F-Sakashita/Micromouse/3DCAD/mount_silk.dxf

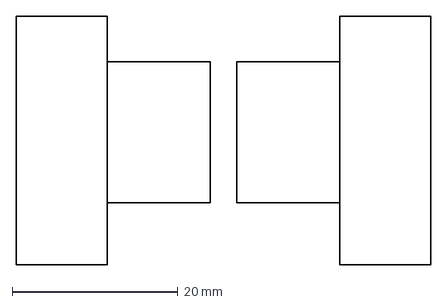
[picture p1: CAD file, 2020-11-21]
3DCAD/mount_silk.dxf
50.0 x 30.0 mm
