F-Sakashita/Micromouse/3DCAD/Chassis_and_Mount.dxf

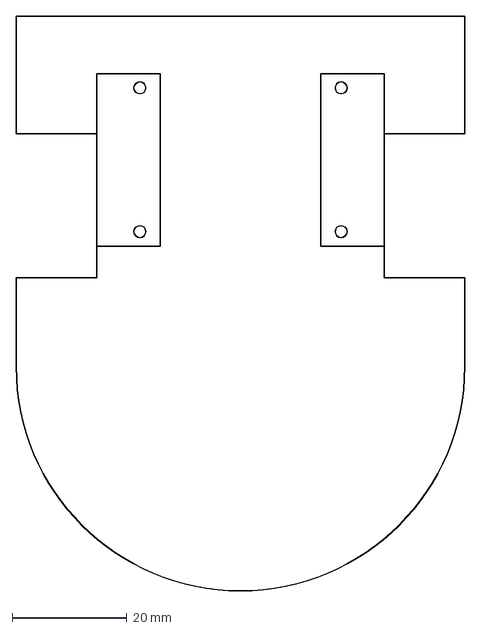
[picture p2: CAD file, 2020-11-15]
3DCAD/Chassis_and_Mount.dxf
78.0 x 100.0 mm
