F-Sakashita/Micromouse/3DCAD/Chassis.dxf

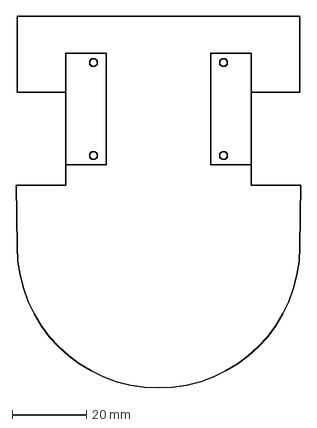
[picture p3: CAD file, 2020-11-14]
3DCAD/Chassis.dxf
76.5 x 100.0 mm
