F-Sakashita/Micromouse/3DCAD/シャーシ.stl

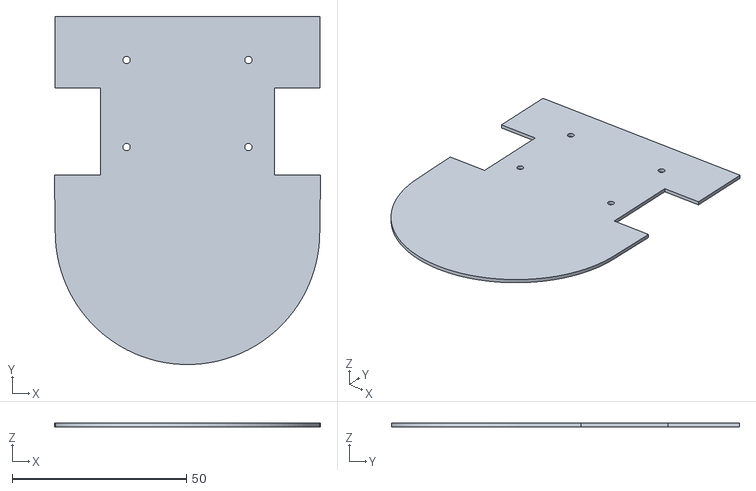
[picture p4: CAD file, 2020-11-14]
3DCAD/シャーシ.stl
76.5 x 100.0 x 1.10
