F-Sakashita/Micromouse/(list of files, cad)

Other CAD files:
3DCAD/シャーシ v1.dxf
