F-Sakashita/Micromouse/circuit/Micromouse.kicad_pcb

## KiCad design circuit/Micromouse.kicad_pcb (2021-02-14)

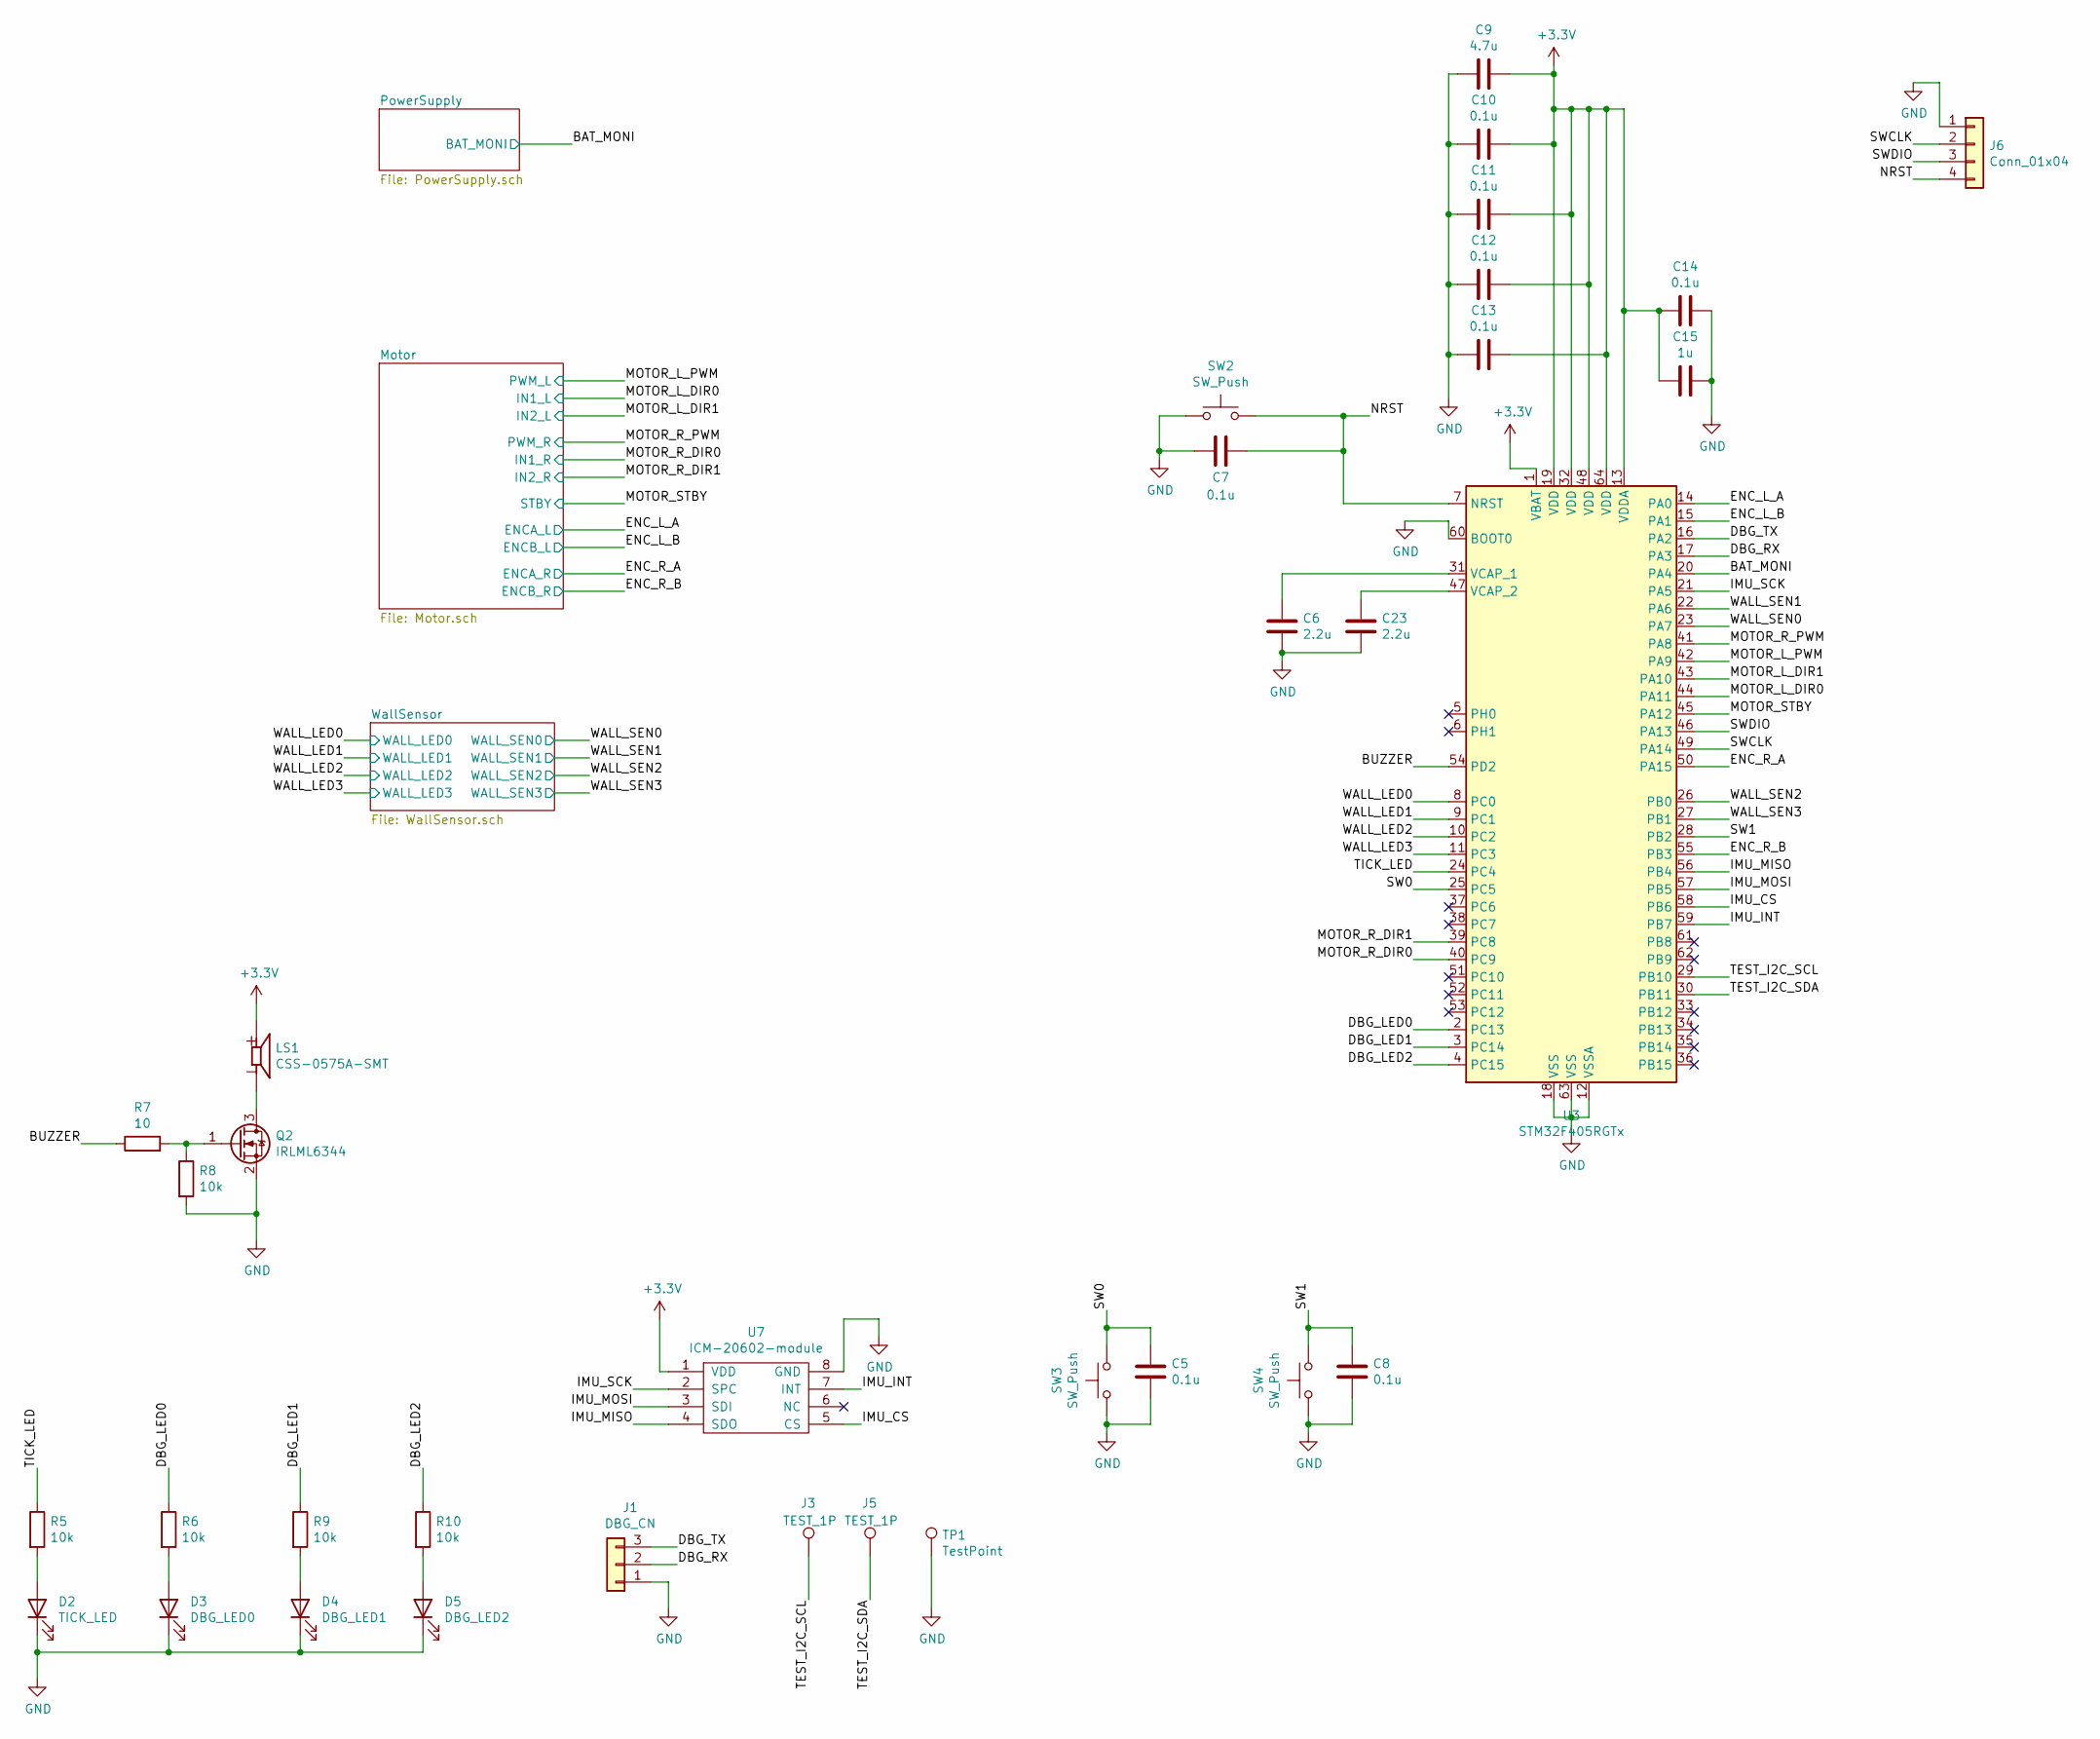
[picture p5: schematic Micromouse.sch]

Parts:
C5, C7, C8, C10, C11, C12, C13, C14: 0.1u; C_0603_1608Metric
C6, C23: 2.2u; C_0603_1608Metric
C9: 4.7u; C_0603_1608Metric
C15: 1u; C_0603_1608Metric
D2: TICK_LED; LED_0603_1608Metric
D3: DBG_LED0; LED_0603_1608Metric
D4: DBG_LED1; LED_0603_1608Metric
D5: DBG_LED2; LED_0603_1608Metric
J1: DBG_CN; PinSocket_1x03_P2.54mm_Vertical
J3, J5: TEST_1P; TestPoint_Pad_D1.0mm
J6: Conn_01x04; PinSocket_1x04_P2.54mm_Vertical
LS1: CSS-0575A-SMT; CUI_CSS-0575A-SMT
Q2: IRLML6344; SOT-23
R5, R6, R8, R9, R10: 10k; R_0603_1608Metric
R7: 10; R_0603_1608Metric
SW2, SW3, SW4: SW_Push; SW_TACT_ALPS_SKRPABE010
TP1: TestPoint; TestPoint_Pad_D1.0mm
U3: STM32F405RGTx; LQFP-64_10x10mm_P0.5mm
U7: ICM-20602-module; ICM-20602

Connections:
+3V3: C9.1, C10.1, C11.1, C12.1, C13.1, C14.2, C15.2, LS1.1, U3.1 (VBAT), U3.13 (VDDA), U3.19 (VDD), U3.32 (VDD), U3.48 (VDD), U3.64 (VDD), U7.1 (VDD); also elsewhere on the board
/BAT_MONI: U3.20 (PA4); also elsewhere on the board
/BUZZER: R7.1, U3.54 (PD2)
/DBG_LED0: R6.1, U3.2 (PC13)
/DBG_LED1: R9.1, U3.3 (PC14)
/DBG_LED2: R10.1, U3.4 (PC15)
/DBG_RX: J1.2, U3.17 (PA3)
/DBG_TX: J1.3, U3.16 (PA2)
/ENC_L_A: U3.14 (PA0); also elsewhere on the board
/ENC_L_B: U3.15 (PA1); also elsewhere on the board
/ENC_R_A: U3.50 (PA15); also elsewhere on the board
/ENC_R_B: U3.55 (PB3); also elsewhere on the board
/IMU_CS: U3.58 (PB6), U7.5 (CS)
/IMU_INT: U3.59 (PB7), U7.7 (INT)
/IMU_MISO: U3.56 (PB4), U7.4 (SDO)
/IMU_MOSI: U3.57 (PB5), U7.3 (SDI)
/IMU_SCK: U3.21 (PA5), U7.2 (SPC)
/MOTOR_L_DIR0: U3.44 (PA11); also elsewhere on the board
/MOTOR_L_DIR1: U3.43 (PA10); also elsewhere on the board
/MOTOR_L_PWM: U3.42 (PA9); also elsewhere on the board
/MOTOR_R_DIR0: U3.40 (PC9); also elsewhere on the board
/MOTOR_R_DIR1: U3.39 (PC8); also elsewhere on the board
/MOTOR_R_PWM: U3.41 (PA8); also elsewhere on the board
/MOTOR_STBY: U3.45 (PA12); also elsewhere on the board
/NRST: C7.1, J6.4, SW2.2, U3.7 (NRST)
/SW0: C5.1, SW3.2, U3.25 (PC5)
/SW1: C8.1, SW4.2, U3.28 (PB2)
/SWCLK: J6.2, U3.49 (PA14)
/SWDIO: J6.3, U3.46 (PA13)
/TEST_I2C_SCL: J3.1, U3.29 (PB10)
/TEST_I2C_SDA: J5.1, U3.30 (PB11)
/TICK_LED: R5.1, U3.24 (PC4)
/WALL_LED0: U3.8 (PC0); also elsewhere on the board
/WALL_LED1: U3.9 (PC1); also elsewhere on the board
/WALL_LED2: U3.10 (PC2); also elsewhere on the board
/WALL_LED3: U3.11 (PC3); also elsewhere on the board
/WALL_SEN0: U3.23 (PA7); also elsewhere on the board
/WALL_SEN1: U3.22 (PA6); also elsewhere on the board
/WALL_SEN2: U3.26 (PB0); also elsewhere on the board
/WALL_SEN3: U3.27 (PB1); also elsewhere on the board
GND: C5.2, C6.2, C7.2, C8.2, C9.2, C10.2, C11.2, C12.2, C13.2, C14.1, C15.1, C23.2, D2.1 (K), D3.1 (K), D4.1 (K), D5.1 (K), J1.1, J6.1, Q2.2 (S), R8.2, SW2.1, SW3.1, SW4.1, TP1.1, U3.12 (VSSA), U3.18 (VSS), U3.60 (BOOT0), U3.63 (VSS), U7.8 (GND); also elsewhere on the board
unnamed: C6.1, U3.31 (VCAP_1)
unnamed: C23.1, U3.47 (VCAP_2)
unnamed: D2.2 (A), R5.2
unnamed: D3.2 (A), R6.2
unnamed: D4.2 (A), R9.2
unnamed: D5.2 (A), R10.2
unnamed: LS1.2, Q2.3 (D)
unnamed: Q2.1 (G), R7.2, R8.1

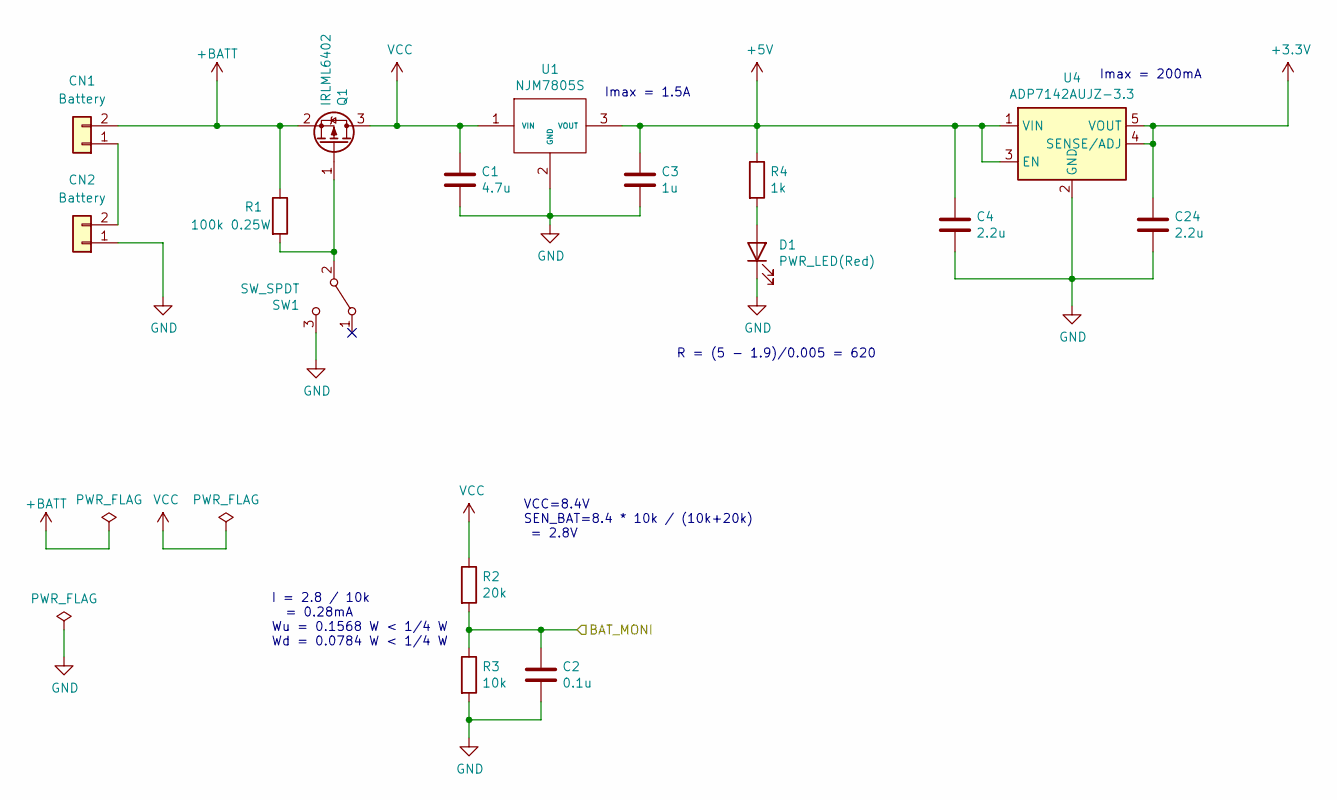
[picture p6: schematic PowerSupply.sch]

Parts:
C1: 4.7u; C_0805_2012Metric
C2: 0.1u; C_0603_1608Metric
C3: 1u; C_0603_1608Metric
C4, C24: 2.2u; C_0603_1608Metric
CN1, CN2: Battery; JST_PH_B2B-PH-K_1x02_P2.00mm_Vertical
D1: PWR_LED(Red); LED_0603_1608Metric
Q1: IRLML6402; SOT-23
R1: 100k 0.25W; R_0603_1608Metric
R2: 20k; R_0805_2012Metric
R3: 10k; R_0805_2012Metric
R4: 1k; R_0603_1608Metric
SW1: SW_SPDT; SW_CuK_JS202011CQN_DPDT_Straight
U1: NJM7805S; TO-252-2
U4: ADP7142AUJZ-3.3; TSOT-23-5

Connections:
+3V3: C24.1, U4.4 (SENSE/ADJ), U4.5 (VOUT); also elsewhere on the board
+5V: C3.1, C4.1, R4.1, U1.3 (VOUT), U4.1 (VIN), U4.3 (EN); also elsewhere on the board
+BATT: CN1.2, Q1.2 (S), R1.1
/BAT_MONI: C2.1, R2.2, R3.1; also elsewhere on the board
GND: C1.2, C2.2, C3.2, C4.2, C24.2, CN2.1, D1.1 (K), R3.2, SW1.3 (C), U1.2 (GND), U4.2 (GND); also elsewhere on the board
unnamed: CN1.1, CN2.2
unnamed: D1.2 (A), R4.2
unnamed 64: Q1.1 (G), R1.2, SW1.2 (B); also elsewhere on the board
VCC: C1.1, Q1.3 (D), R2.1, U1.1 (VIN); also elsewhere on the board

Notes on the sheet:
VCC=8.4V SEN_BAT=8.4 * 10k / (10k+20k) = 2.8V
Imax = 1.5A
Imax = 200mA
R = (5 - 1.9)/0.005 = 620
I = 2.8 / 10k = 0.28mA Wu = 0.1568 W < 1/4 W Wd = 0.0784 W < 1/4 W

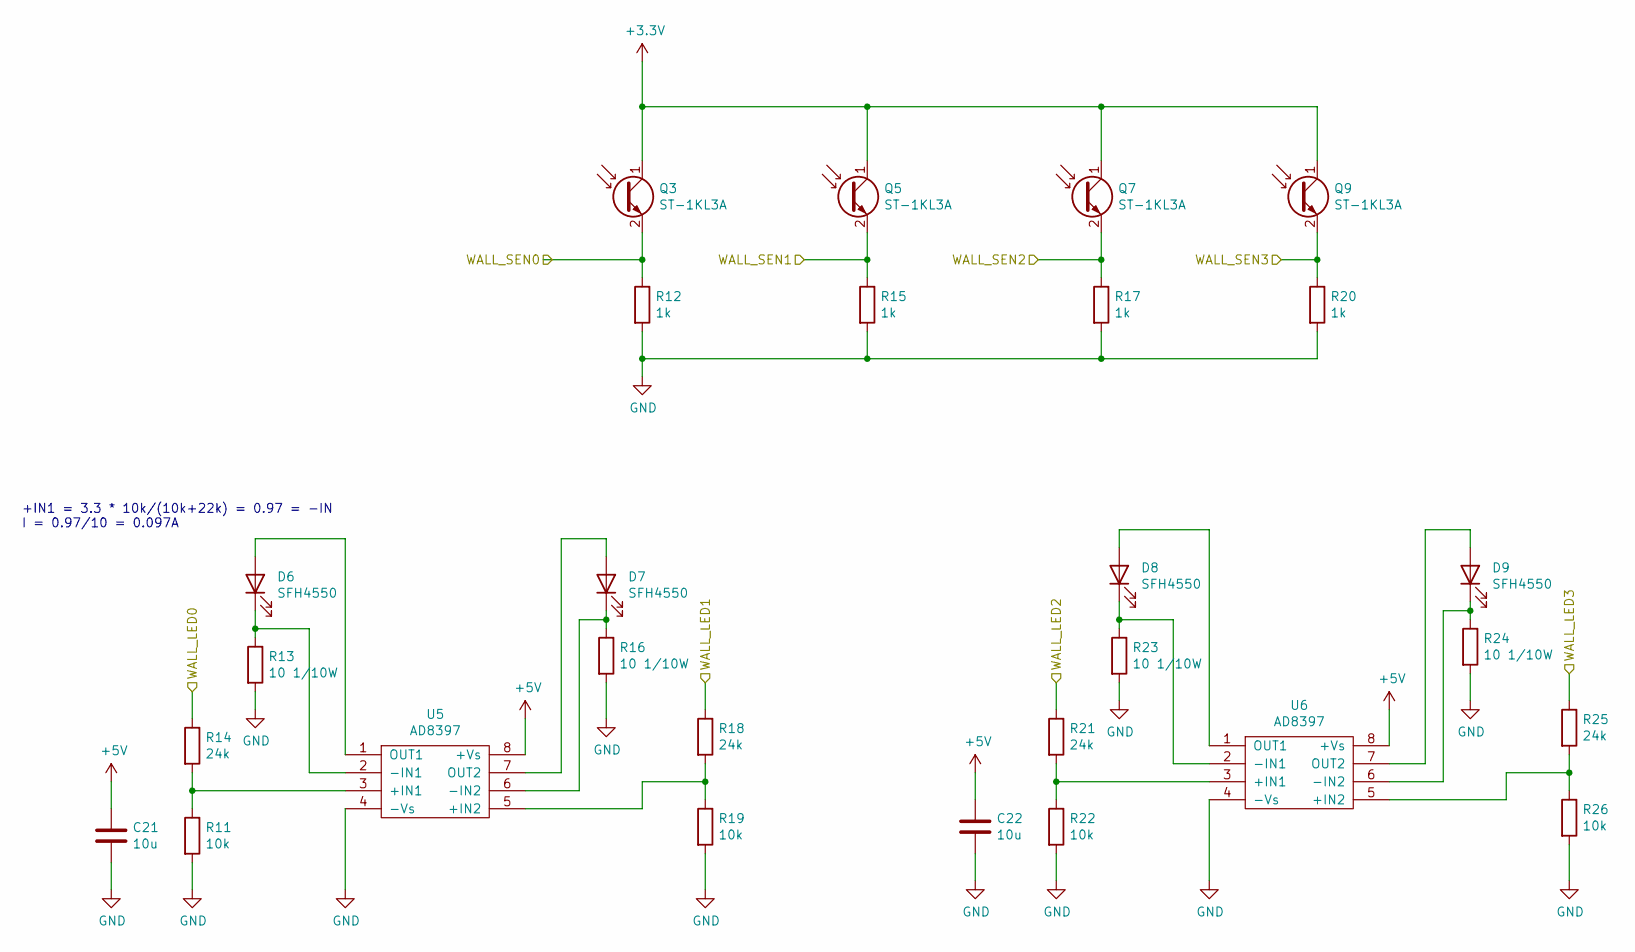
[picture p7: schematic WallSensor.sch]

Parts:
C21, C22: 10u; C_0603_1608Metric
D6, D7: SFH4550; LED_D5.0mm_Horizontal_O3.81mm_Z9.0mm
D8, D9: SFH4550; LED_D5.0mm_Horizontal_O3.81mm_Z9.0mm_reverse
Q3, Q5, Q7, Q9: ST-1KL3A; ST-1KL3A_ForWall
R11, R19, R22, R26: 10k; R_0603_1608Metric
R12, R15, R17, R20: 1k; R_0603_1608Metric
R13, R16, R23, R24: 10 1/10W; R_0603_1608Metric
R14, R18, R21, R25: 24k; R_0603_1608Metric
U5, U6: AD8397; SOIC-8_3.9x4.9mm_P1.27mm

Connections:
+3V3: Q3.1 (C), Q5.1 (C), Q7.1 (C), Q9.1 (C); also elsewhere on the board
+5V: C21.1, C22.1, U5.8 (+Vs), U6.8 (+Vs); also elsewhere on the board
/WALL_LED0: R14.1; also elsewhere on the board
/WALL_LED1: R18.1; also elsewhere on the board
/WALL_LED2: R21.1; also elsewhere on the board
/WALL_LED3: R25.1; also elsewhere on the board
/WALL_SEN0: Q3.2 (E), R12.1; also elsewhere on the board
/WALL_SEN1: Q5.2 (E), R15.1; also elsewhere on the board
/WALL_SEN2: Q7.2 (E), R17.1; also elsewhere on the board
/WALL_SEN3: Q9.2 (E), R20.1; also elsewhere on the board
GND: C21.2, C22.2, R11.2, R12.2, R13.2, R15.2, R16.2, R17.2, R19.2, R20.2, R22.2, R23.2, R24.2, R26.2, U5.4 (-Vs), U6.4 (-Vs); also elsewhere on the board
unnamed: D6.1 (K), R13.1, U5.2 (-IN1)
unnamed: D6.2 (A), U5.1 (OUT1)
unnamed: D7.1 (K), R16.1, U5.6 (-IN2)
unnamed: D7.2 (A), U5.7 (OUT2)
unnamed: D8.1 (K), R23.1, U6.2 (-IN1)
unnamed: D8.2 (A), U6.1 (OUT1)
unnamed: D9.1 (K), R24.1, U6.6 (-IN2)
unnamed: D9.2 (A), U6.7 (OUT2)
unnamed: R11.1, R14.2, U5.3 (+IN1)
unnamed: R18.2, R19.1, U5.5 (+IN2)
unnamed: R21.2, R22.1, U6.3 (+IN1)
unnamed: R25.2, R26.1, U6.5 (+IN2)

Notes on the sheet:
+IN1 = 3.3 * 10k/(10k+22k) = 0.97 = -IN I = 0.97/10 = 0.097A

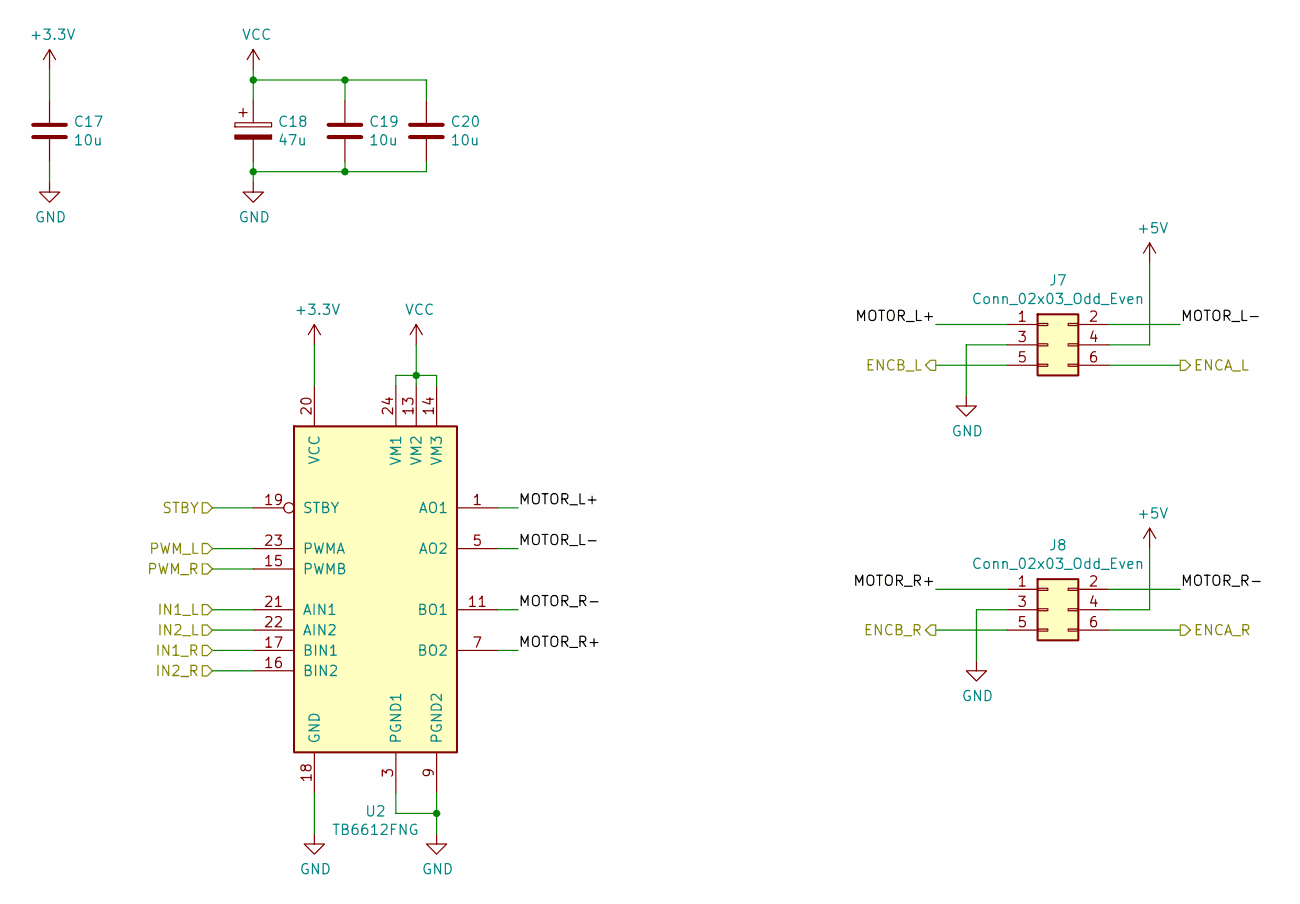
[picture p8: schematic Motor.sch]

Parts:
C17, C19, C20: 10u; C_0805_2012Metric
C18: 47u; CP_Elec_6.3x7.7
J7, J8: Conn_02x03_Odd_Even; IDC-Header_2x03_P2.54mm_Vertical
U2: TB6612FNG; SSOP-24_5.3x8.2mm_P0.65mm

Connections:
+3V3: C17.1, U2.20 (VCC); also elsewhere on the board
+5V: J7.4, J8.4; also elsewhere on the board
/ENC_L_A: J7.6; also elsewhere on the board
/ENC_L_B: J7.5; also elsewhere on the board
/ENC_R_A: J8.6; also elsewhere on the board
/ENC_R_B: J8.5; also elsewhere on the board
/MOTOR_L_DIR0: U2.21 (AIN1); also elsewhere on the board
/MOTOR_L_DIR1: U2.22 (AIN2); also elsewhere on the board
/MOTOR_L_PWM: U2.23 (PWMA); also elsewhere on the board
/MOTOR_R_DIR0: U2.17 (BIN1); also elsewhere on the board
/MOTOR_R_DIR1: U2.16 (BIN2); also elsewhere on the board
/MOTOR_R_PWM: U2.15 (PWMB); also elsewhere on the board
/MOTOR_STBY: U2.19 (STBY); also elsewhere on the board
/Motor/MOTOR_L+: J7.1, U2.1 (AO1), U2.2 (AO1)
/Motor/MOTOR_L-: J7.2, U2.5 (AO2), U2.6 (AO2)
/Motor/MOTOR_R+: J8.1, U2.7 (BO2), U2.8 (BO2)
/Motor/MOTOR_R-: J8.2, U2.11 (BO1), U2.12 (BO1)
GND: C17.2, C18.2, C19.2, C20.2, J7.3, J8.3, U2.3 (PGND1), U2.4 (PGND1), U2.9 (PGND2), U2.10 (PGND2), U2.18 (GND); also elsewhere on the board
VCC: C18.1, C19.1, C20.1, U2.13 (VM2), U2.14 (VM3), U2.24 (VM1); also elsewhere on the board

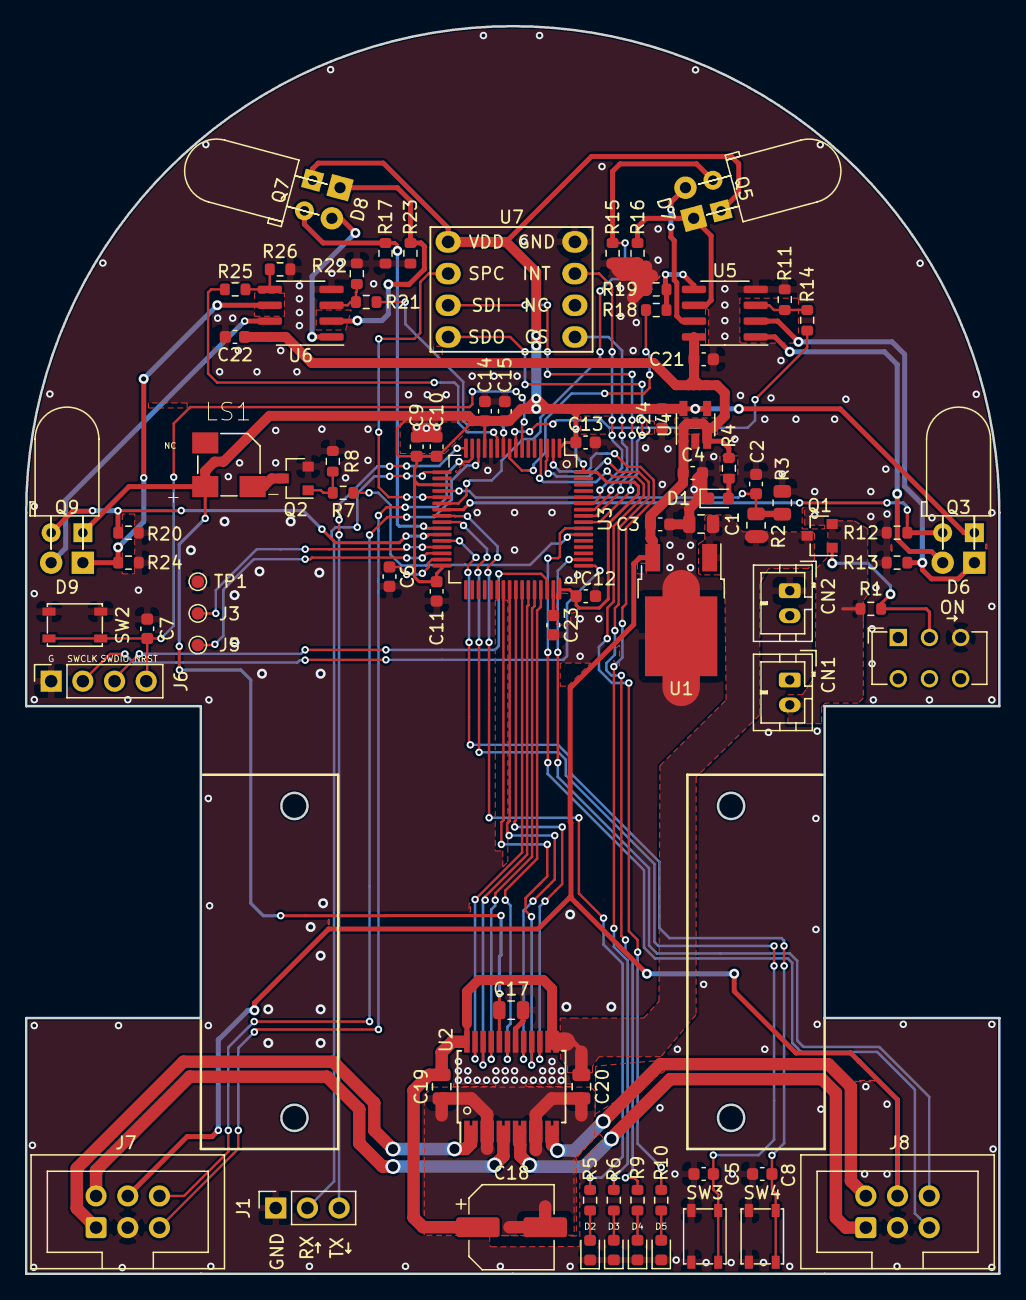
[picture p9: board Micromouse.kicad_pcb from above]

Board: 2 copper layers, 78.0 x 100.0 mm, 85 parts (0 on the bottom side), 71 nets.

Other parts of the board:
ON: SW_SPDT; SW_CuK_JS202011CQN_DPDT_Straight

Their connections:
GND: ON.3; also elsewhere on the board
unnamed 64: ON.2; also elsewhere on the board
