F-Sakashita/Micromouse/firmware/Prototype/Prototype.ioc

PB6.GPIO_Label=IMU_CS
PA6.GPIO_Label=WALL_SEN1
PC15-OSC32_OUT.GPIO_Label=DBG_LED2
PB6.Signal=GPIO_Output
PC3.Signal=GPIO_Output
PB2.Signal=GPIO_Input
PC13-ANTI_TAMP.Signal=GPIO_Output
PC4.GPIO_Label=TICK_LED
PB1.GPIO_Label=WALL_SEN3
PA8.Signal=S_TIM1_CH1
PB1.Signal=ADCx_IN9
PA10.Signal=GPIO_Output
PA4.GPIO_Label=BAT_MONI
PC13-ANTI_TAMP.GPIO_Label=DBG_LED0
PA9.GPIO_Label=MOTOR_L_PWM
PC2.Signal=GPIO_Output
PA11.GPIO_Label=MOTOR_L_DIR0
PC0.Signal=GPIO_Output
PC14-OSC32_IN.Signal=GPIO_Output
PA0-WKUP.GPIO_Label=ENC_R_A
PA0-WKUP.Signal=S_TIM5_CH1
PA8.GPIO_Label=MOTOR_R_PWM
PA9.Signal=S_TIM1_CH2
PB10.Signal=I2C2_SCL
PA5.Signal=SPI1_SCK
PB4.GPIO_Label=IMU_MISO
PA1.GPIO_Label=ENC_R_B
PA4.Signal=ADCx_IN4
PB5.Signal=SPI1_MOSI
PA5.GPIO_Label=IMU_SCK
PA11.Signal=GPIO_Output
PC3.GPIO_Label=WALL_LED3
PD2.Signal=GPIO_Output
PB0.Signal=ADCx_IN8
PC1.Signal=GPIO_Output
PD2.GPIO_Label=BUZZER
Mcu.UserName=STM32F405RGTx
PC0.GPIO_Label=WALL_LED0
PB0.GPIO_Label=WALL_SEN2
PB11.Signal=I2C2_SDA
PA15.GPIO_Label=ENC_L_A
PA12.Signal=GPIO_Output
PA10.GPIO_Label=MOTOR_L_DIR1
PB7.Signal=GPIO_Input
PB7.GPIO_Label=IMU_INT
PA6.Signal=ADCx_IN6
PA2.GPIO_Label=DBG_TX
PA15.Signal=S_TIM2_CH1_ETR
PB5.GPIO_Label=IMU_MOSI
PC14-OSC32_IN.GPIO_Label=DBG_LED1
PC5.Signal=GPIO_Input
PC2.GPIO_Label=WALL_LED2
PB4.Signal=SPI1_MISO
PA3.Signal=USART2_RX
PB3.GPIO_Label=ENC_L_B
PC9.GPIO_Label=MOTOR_R_DIR0
PC8.Signal=GPIO_Output
PC4.Signal=GPIO_Output
PA12.GPIO_Label=MOTOR_STBY
PC8.GPIO_Label=MOTOR_R_DIR1
PA13.Signal=SYS_JTMS-SWDIO
PC15-OSC32_OUT.Signal=GPIO_Output
PA1.Signal=S_TIM5_CH2
PC1.GPIO_Label=WALL_LED1
PA2.Signal=USART2_TX
PB3.Signal=S_TIM2_CH2
PA7.GPIO_Label=WALL_SEN0
PC5.GPIO_Label=SW0
PA14.Signal=SYS_JTCK-SWCLK
PB2.GPIO_Label=SW1
PC9.Signal=GPIO_Output
PA3.GPIO_Label=DBG_RX
PA7.Signal=ADCx_IN7
