F-Sakashita/Micromouse/firmware/Prototype/Core/Src/tim.c

/**
  ******************************************************************************
  * @file    tim.c
  * @brief   This file provides code for the configuration
  *          of the TIM instances.
  ******************************************************************************
  * @attention
  *
  * <h2><center>&copy; Copyright (c) 2021 STMicroelectronics.
  * All rights reserved.</center></h2>
  *
  * This software component is licensed by ST under Ultimate Liberty license
  * SLA0044, the "License"; You may not use this file except in compliance with
  * the License. You may obtain a copy of the License at:
  *                             www.st.com/SLA0044
  *
  ******************************************************************************
  */

/* Includes ------------------------------------------------------------------*/
#include "tim.h"

/* USER CODE BEGIN 0 */
#include <stdio.h>
/* USER CODE END 0 */

/* TIM1 init function */
void MX_TIM1_Init(void)
{

  LL_TIM_InitTypeDef TIM_InitStruct = {0};
  LL_TIM_OC_InitTypeDef TIM_OC_InitStruct = {0};
  LL_TIM_BDTR_InitTypeDef TIM_BDTRInitStruct = {0};

  LL_GPIO_InitTypeDef GPIO_InitStruct = {0};
  /* Peripheral clock enable */
  LL_APB2_GRP1_EnableClock(LL_APB2_GRP1_PERIPH_TIM1);

  TIM_InitStruct.Prescaler = LL_TIM_IC_FILTER_FDIV1_N2-LL_TIM_IC_FILTER_FDIV1_N2;
  TIM_InitStruct.CounterMode = LL_TIM_COUNTERMODE_UP;
  TIM_InitStruct.Autoreload = 1680-LL_TIM_IC_FILTER_FDIV1_N2;
  TIM_InitStruct.ClockDivision = LL_TIM_CLOCKDIVISION_DIV1;
  TIM_InitStruct.RepetitionCounter = 0;
  LL_TIM_Init(TIM1, &TIM_InitStruct);
  LL_TIM_EnableARRPreload(TIM1);
  LL_TIM_SetClockSource(TIM1, LL_TIM_CLOCKSOURCE_INTERNAL);
  LL_TIM_OC_EnablePreload(TIM1, LL_TIM_CHANNEL_CH1);
  TIM_OC_InitStruct.OCMode = LL_TIM_OCMODE_PWM1;
  TIM_OC_InitStruct.OCState = LL_TIM_OCSTATE_DISABLE;
  TIM_OC_InitStruct.OCNState = LL_TIM_OCSTATE_DISABLE;
  TIM_OC_InitStruct.CompareValue = 0;
  TIM_OC_InitStruct.OCPolarity = LL_TIM_OCPOLARITY_HIGH;
  TIM_OC_InitStruct.OCNPolarity = LL_TIM_OCPOLARITY_HIGH;
  TIM_OC_InitStruct.OCIdleState = LL_TIM_OCIDLESTATE_LOW;
  TIM_OC_InitStruct.OCNIdleState = LL_TIM_OCIDLESTATE_LOW;
  LL_TIM_OC_Init(TIM1, LL_TIM_CHANNEL_CH1, &TIM_OC_InitStruct);
  LL_TIM_OC_DisableFast(TIM1, LL_TIM_CHANNEL_CH1);
  LL_TIM_OC_EnablePreload(TIM1, LL_TIM_CHANNEL_CH2);
  LL_TIM_OC_Init(TIM1, LL_TIM_CHANNEL_CH2, &TIM_OC_InitStruct);
  LL_TIM_OC_DisableFast(TIM1, LL_TIM_CHANNEL_CH2);
  LL_TIM_SetTriggerOutput(TIM1, LL_TIM_TRGO_RESET);
  LL_TIM_DisableMasterSlaveMode(TIM1);
  TIM_BDTRInitStruct.OSSRState = LL_TIM_OSSR_DISABLE;
  TIM_BDTRInitStruct.OSSIState = LL_TIM_OSSI_DISABLE;
  TIM_BDTRInitStruct.LockLevel = LL_TIM_LOCKLEVEL_OFF;
  TIM_BDTRInitStruct.DeadTime = 0;
  TIM_BDTRInitStruct.BreakState = LL_TIM_BREAK_DISABLE;
  TIM_BDTRInitStruct.BreakPolarity = LL_TIM_BREAK_POLARITY_HIGH;
  TIM_BDTRInitStruct.AutomaticOutput = LL_TIM_AUTOMATICOUTPUT_DISABLE;
  LL_TIM_BDTR_Init(TIM1, &TIM_BDTRInitStruct);
  LL_AHB1_GRP1_EnableClock(LL_AHB1_GRP1_PERIPH_GPIOA);
    /**TIM1 GPIO Configuration
    PA8     ------> TIM1_CH1
    PA9     ------> TIM1_CH2
    */
  GPIO_InitStruct.Pin = MOTOR_R_PWM_Pin|MOTOR_L_PWM_Pin;
  GPIO_InitStruct.Mode = LL_GPIO_MODE_ALTERNATE;
  GPIO_InitStruct.Speed = LL_GPIO_SPEED_FREQ_LOW;
  GPIO_InitStruct.OutputType = LL_GPIO_OUTPUT_PUSHPULL;
  GPIO_InitStruct.Pull = LL_GPIO_PULL_NO;
  GPIO_InitStruct.Alternate = LL_GPIO_AF_1;
  LL_GPIO_Init(GPIOA, &GPIO_InitStruct);

}
/* TIM2 init function */
void MX_TIM2_Init(void)
{

  LL_TIM_InitTypeDef TIM_InitStruct = {0};

  LL_GPIO_InitTypeDef GPIO_InitStruct = {0};

  /* Peripheral clock enable */
  LL_APB1_GRP1_EnableClock(LL_APB1_GRP1_PERIPH_TIM2);

  LL_AHB1_GRP1_EnableClock(LL_AHB1_GRP1_PERIPH_GPIOA);
  LL_AHB1_GRP1_EnableClock(LL_AHB1_GRP1_PERIPH_GPIOB);
  /**TIM2 GPIO Configuration
  PA15   ------> TIM2_CH1
  PB3   ------> TIM2_CH2
  */
  GPIO_InitStruct.Pin = ENC_L_A_Pin;
  GPIO_InitStruct.Mode = LL_GPIO_MODE_ALTERNATE;
  GPIO_InitStruct.Speed = LL_GPIO_SPEED_FREQ_LOW;
  GPIO_InitStruct.OutputType = LL_GPIO_OUTPUT_PUSHPULL;
  GPIO_InitStruct.Pull = LL_GPIO_PULL_NO;
  GPIO_InitStruct.Alternate = LL_GPIO_AF_1;
  LL_GPIO_Init(ENC_L_A_GPIO_Port, &GPIO_InitStruct);

  GPIO_InitStruct.Pin = ENC_L_B_Pin;
  GPIO_InitStruct.Mode = LL_GPIO_MODE_ALTERNATE;
  GPIO_InitStruct.Speed = LL_GPIO_SPEED_FREQ_LOW;
  GPIO_InitStruct.OutputType = LL_GPIO_OUTPUT_PUSHPULL;
  GPIO_InitStruct.Pull = LL_GPIO_PULL_NO;
  GPIO_InitStruct.Alternate = LL_GPIO_AF_1;
  LL_GPIO_Init(ENC_L_B_GPIO_Port, &GPIO_InitStruct);

  /* TIM2 interrupt Init */
  NVIC_SetPriority(TIM2_IRQn, NVIC_EncodePriority(NVIC_GetPriorityGrouping(),5, 0));
  NVIC_EnableIRQ(TIM2_IRQn);

  LL_TIM_SetEncoderMode(TIM2, LL_TIM_ENCODERMODE_X4_TI12);
  LL_TIM_IC_SetActiveInput(TIM2, LL_TIM_CHANNEL_CH1, LL_TIM_ACTIVEINPUT_DIRECTTI);
  LL_TIM_IC_SetPrescaler(TIM2, LL_TIM_CHANNEL_CH1, LL_TIM_ICPSC_DIV1);
  LL_TIM_IC_SetFilter(TIM2, LL_TIM_CHANNEL_CH1, LL_TIM_IC_FILTER_FDIV1);
  LL_TIM_IC_SetPolarity(TIM2, LL_TIM_CHANNEL_CH1, LL_TIM_IC_POLARITY_RISING);
  LL_TIM_IC_SetActiveInput(TIM2, LL_TIM_CHANNEL_CH2, LL_TIM_ACTIVEINPUT_DIRECTTI);
  LL_TIM_IC_SetPrescaler(TIM2, LL_TIM_CHANNEL_CH2, LL_TIM_ICPSC_DIV1);
  LL_TIM_IC_SetFilter(TIM2, LL_TIM_CHANNEL_CH2, LL_TIM_IC_FILTER_FDIV1);
  LL_TIM_IC_SetPolarity(TIM2, LL_TIM_CHANNEL_CH2, LL_TIM_IC_POLARITY_RISING);
  TIM_InitStruct.Prescaler = 0;
  TIM_InitStruct.CounterMode = LL_TIM_COUNTERMODE_UP;
  TIM_InitStruct.Autoreload = 4294967295;
  TIM_InitStruct.ClockDivision = LL_TIM_CLOCKDIVISION_DIV1;
  LL_TIM_Init(TIM2, &TIM_InitStruct);
  LL_TIM_DisableARRPreload(TIM2);
  LL_TIM_SetTriggerOutput(TIM2, LL_TIM_TRGO_UPDATE);
  LL_TIM_DisableMasterSlaveMode(TIM2);
}
/* TIM3 init function */
void MX_TIM3_Init(void)
{

  LL_TIM_InitTypeDef TIM_InitStruct = {0};

  /* Peripheral clock enable */
  LL_APB1_GRP1_EnableClock(LL_APB1_GRP1_PERIPH_TIM3);

  /* TIM3 interrupt Init */
  NVIC_SetPriority(TIM3_IRQn, NVIC_EncodePriority(NVIC_GetPriorityGrouping(),6, 0));
  NVIC_EnableIRQ(TIM3_IRQn);

  TIM_InitStruct.Prescaler = 100-LL_TIM_IC_FILTER_FDIV1_N2;
  TIM_InitStruct.CounterMode = LL_TIM_COUNTERMODE_UP;
  TIM_InitStruct.Autoreload = 1680-LL_TIM_IC_FILTER_FDIV1_N2;
  TIM_InitStruct.ClockDivision = LL_TIM_CLOCKDIVISION_DIV1;
  LL_TIM_Init(TIM3, &TIM_InitStruct);
  LL_TIM_DisableARRPreload(TIM3);
  LL_TIM_SetClockSource(TIM3, LL_TIM_CLOCKSOURCE_INTERNAL);
  LL_TIM_SetTriggerOutput(TIM3, LL_TIM_TRGO_UPDATE);
  LL_TIM_DisableMasterSlaveMode(TIM3);
}
/* TIM5 init function */
void MX_TIM5_Init(void)
{

  LL_TIM_InitTypeDef TIM_InitStruct = {0};

  LL_GPIO_InitTypeDef GPIO_InitStruct = {0};

  /* Peripheral clock enable */
  LL_APB1_GRP1_EnableClock(LL_APB1_GRP1_PERIPH_TIM5);

  LL_AHB1_GRP1_EnableClock(LL_AHB1_GRP1_PERIPH_GPIOA);
  /**TIM5 GPIO Configuration
  PA0-WKUP   ------> TIM5_CH1
  PA1   ------> TIM5_CH2
  */
  GPIO_InitStruct.Pin = ENC_R_A_Pin|ENC_R_B_Pin;
  GPIO_InitStruct.Mode = LL_GPIO_MODE_ALTERNATE;
  GPIO_InitStruct.Speed = LL_GPIO_SPEED_FREQ_LOW;
  GPIO_InitStruct.OutputType = LL_GPIO_OUTPUT_PUSHPULL;
  GPIO_InitStruct.Pull = LL_GPIO_PULL_NO;
  GPIO_InitStruct.Alternate = LL_GPIO_AF_2;
  LL_GPIO_Init(GPIOA, &GPIO_InitStruct);

  /* TIM5 interrupt Init */
  NVIC_SetPriority(TIM5_IRQn, NVIC_EncodePriority(NVIC_GetPriorityGrouping(),5, 0));
  NVIC_EnableIRQ(TIM5_IRQn);

  LL_TIM_SetEncoderMode(TIM5, LL_TIM_ENCODERMODE_X4_TI12);
  LL_TIM_IC_SetActiveInput(TIM5, LL_TIM_CHANNEL_CH1, LL_TIM_ACTIVEINPUT_DIRECTTI);
  LL_TIM_IC_SetPrescaler(TIM5, LL_TIM_CHANNEL_CH1, LL_TIM_ICPSC_DIV1);
  LL_TIM_IC_SetFilter(TIM5, LL_TIM_CHANNEL_CH1, LL_TIM_IC_FILTER_FDIV1);
  LL_TIM_IC_SetPolarity(TIM5, LL_TIM_CHANNEL_CH1, LL_TIM_IC_POLARITY_RISING);
  LL_TIM_IC_SetActiveInput(TIM5, LL_TIM_CHANNEL_CH2, LL_TIM_ACTIVEINPUT_DIRECTTI);
  LL_TIM_IC_SetPrescaler(TIM5, LL_TIM_CHANNEL_CH2, LL_TIM_ICPSC_DIV1);
  LL_TIM_IC_SetFilter(TIM5, LL_TIM_CHANNEL_CH2, LL_TIM_IC_FILTER_FDIV1);
  LL_TIM_IC_SetPolarity(TIM5, LL_TIM_CHANNEL_CH2, LL_TIM_IC_POLARITY_RISING);
  TIM_InitStruct.Prescaler = 0;
  TIM_InitStruct.CounterMode = LL_TIM_COUNTERMODE_UP;
  TIM_InitStruct.Autoreload = 4294967295;
  TIM_InitStruct.ClockDivision = LL_TIM_CLOCKDIVISION_DIV1;
  LL_TIM_Init(TIM5, &TIM_InitStruct);
  LL_TIM_DisableARRPreload(TIM5);
  LL_TIM_SetTriggerOutput(TIM5, LL_TIM_TRGO_UPDATE);
  LL_TIM_DisableMasterSlaveMode(TIM5);
}

/* USER CODE BEGIN 1 */
void TIM_StartPWM(TIM_TypeDef *TIMx, uint32_t uiChannel)
{
  if(LL_TIM_CHANNEL_CH1 > uiChannel || LL_TIM_CHANNEL_CH4 < uiChannel){
    return;
  }
  LL_TIM_CC_EnableChannel(TIMx, uiChannel);
  if(0u == LL_TIM_IsEnabledCounter(TIMx)){
      LL_TIM_EnableCounter(TIMx);
      LL_TIM_EnableAllOutputs(TIMx);
  }
}

void TIM_StopPWM(TIM_TypeDef *TIMx, uint32_t uiChannel)
{
  if(LL_TIM_CHANNEL_CH1 > uiChannel || LL_TIM_CHANNEL_CH4 < uiChannel){
    return;
  }
  
  if(1u == LL_TIM_CC_IsEnabledChannel(TIMx, uiChannel)){
    LL_TIM_CC_DisableChannel(TIMx, uiChannel);
    LL_TIM_DisableCounter(TIMx);
    LL_TIM_DisableAllOutputs(TIMx);
  }
}

void TIM_SetPWMDuty(TIM_TypeDef *TIMx, uint32_t uiChannel, float fDuty)
{
  uint32_t uiAutoReload = LL_TIM_GetAutoReload(TIMx);
  uint32_t uiCompareValue = (uint32_t)((float)uiAutoReload * fDuty);

  switch(uiChannel)
  {
    case LL_TIM_CHANNEL_CH1:
      LL_TIM_OC_SetCompareCH1(TIMx, uiCompareValue);  
      break;
    case LL_TIM_CHANNEL_CH2:
      LL_TIM_OC_SetCompareCH2(TIMx, uiCompareValue);
      break;
    case LL_TIM_CHANNEL_CH3:
      LL_TIM_OC_SetCompareCH3(TIMx, uiCompareValue);
      break;
    case LL_TIM_CHANNEL_CH4:
      LL_TIM_OC_SetCompareCH4(TIMx, uiCompareValue);
      break;
    default:
      /* do nothing */
      break;
  }
  //printf("TIM1 OC Ch1 Comp:%d\n", LL_TIM_OC_GetCompareCH1(TIM1));
  //printf("TIM1 OC Ch2 Comp:%d\n", LL_TIM_OC_GetCompareCH2(TIM1));
}
/* USER CODE END 1 */

/************************ (C) COPYRIGHT STMicroelectronics *****END OF FILE****/
