F-Sakashita/Micromouse/firmware/Source/HAL/HardwareDriver/BatteryMonitor.cpp

#include "BatteryMonitor.hpp"
#include "adc.h"

const BatteryMonitor::Threshold_t BatteryMonitor::stThreshold = {
    8.50f,  /* Upper Threshold */
    7.00f   /* Lower Threshold */
};

const float BatteryMonitor::fGain = 3.3f * 3.0f;    /* Vref * (10k+20k)/10k */


BatteryMonitor::BatteryMonitor()
{
    fVoltage = 0.0;
    fOffset = 0.0;
    fPercentage = 0.0;
    bIsUpperError = false;
    bIsLowerError = false;
    fFullVoltage = 1.0f;
    bInitialized = false;
    uiUpperErrorCount = 0u;
    uiLowerErrorCount = 0u;
}

BatteryMonitor::~BatteryMonitor()
{
}

bool BatteryMonitor::Initialize(float fFullVoltage)
{
    if(fFullVoltage < 0.0){
        return false;
    }

    this->fFullVoltage = fFullVoltage;
    if(!Adc_IsStartConvert(EN_ADC_NUM_1)){
        Adc_StartConvert(EN_ADC_NUM_1);
    }
    bInitialized = true;
    return true;
}

void BatteryMonitor::Update()
{
    if(fFullVoltage < 0.0){
        return;
    }
    if(bInitialized){
        fVoltage = fGain * Adc_GetRateAdcChannelValue(EN_ADC_NUM_1, DEF_ADC_CHANNEL_RANK) - fOffset;
        fPercentage = fVoltage / fFullVoltage;

        if(fVoltage < stThreshold.fLower){
            uiLowerErrorCount ++;
        }else if(fVoltage > stThreshold.fUpper){
            uiUpperErrorCount ++;
        }else{
            uiUpperErrorCount = 0u;
            uiLowerErrorCount = 0u; 
        }

        if(uiLowerErrorCount >= DEF_ERR_COUNT_MAX){
            bIsUpperError = false;
            bIsLowerError = true;
        }else if(uiUpperErrorCount >= DEF_ERR_COUNT_MAX){
            bIsUpperError = true;
            bIsLowerError = false;
        }else{
            bIsUpperError = false;
            bIsLowerError = false;
        }
    }
}
