F-Sakashita/Micromouse/(commit log)

2020-11-01 回路設計ほぼ完了．FWのProject作成＆ピン配置決定
2020-11-02 あってぃ！
    今月中にElecrow発注したいんじゃ〜〜〜
    [Buzzer.sch, IMU.sch, MCU.sch, Micromouse.sch, Motor.sch, PowerSupply.sch, WallSensor.sch]
2020-11-09 Kicad v5.1.8対応
    [Micromouse.kicad_pcb, Micromouse.sch, Motor.sch, PowerSupply.sch, WallSensor.sch]
2020-11-14 Kicadのpcbnew映らないくてキレそう
    [Micromouse.sch, Motor.sch, PowerSupply.sch, WallSensor.sch]
2020-11-14 スーパーエンジニアの登竜門たる文彦は当然スーパーエンジニア
    あってぃ許さない
    [Chassis.dxf, Micromouse.kicad_pcb, Micromouse.sch, Motor.sch, PowerSupply.sch, WallSensor.sch, シャーシ v1.dxf, シャーシ.stl]
2020-11-15 AW何も分からん
    [Chassis_and_Mount.dxf, Micromouse.kicad_pcb, Micromouse.sch, WallSensor.sch, mount_silk.dxf]
2020-11-15 ぽんぽんぺいん
    [Micromouse.kicad_pcb, Micromouse.sch]
2020-11-16 何となーくの部品配置
    [Micromouse.kicad_pcb]
2020-11-21 配置大体完了．配線分からん
    [Micromouse.kicad_pcb, mount_silk.dxf]
2020-11-22 1A＝1ｍｍ・・・結構大変
    [Micromouse.kicad_pcb]
2020-11-22 技術メモを追加
2020-11-24 ベタ配線のやり方ちょっとわかってきた
    [Micromouse.kicad_pcb]
2020-12-06 残すはGNDビアとGND分離・・・
    [Micromouse.kicad_pcb, Micromouse.sch]
2020-12-12 AW終わったああああああああああああああ（はず）
    [Micromouse.kicad_pcb, Micromouse.sch]
2020-12-30 ICM-20602の値読めた〜〜
2020-12-31 大晦日に進捗出したぞオラッ！！！！！
    角速度と加速度値とれたにゃ〜〜！！
2021-01-10 Buttonクラス追加，ICM20602クラスOffset関数定義（未実装）
    [Micromouse.sch, PowerSupply.sch]
2021-02-14 ヨー角ヨー角ヨー角
    [Micromouse-B_Cu.gbr, Micromouse-B_Mask.gbr, Micromouse-Edge_Cuts.gbr, Micromouse-F_CrtYd.gbr, Micromouse-F_Cu.gbr, Micromouse-F_Fab.gbr, Micromouse-F_Mask.gbr, Micromouse-F_SilkS.gbr]
2021-02-28 壁センサ読めた！
2021-03-26 モータ回った！
2021-04-15 数億年ぶりのコミット
2021-05-18 Delay関数のバグを直したらジャイロ動いた．
    でもまだオドメトリ計算がおかしい
2021-06-06 愛は世界を救う
    愛ゲインをあげたら幸せになった
    [20210606_AngVel.csv, 20210606_AngVelSin.csv]
2021-06-11 モータ制御を有効にするとジャイロが狂うバグ発生
    [20210606_Ang.csv, 20210606_AngVel.csv, 20210606_AngVel2.csv, 20210606_AngVelSin.csv]
2021-06-13 宴会芸できた
    [20210606_Ang.csv, 20210606_AngVel2.csv]
2021-06-13 速度制御タスクをリファクタリング（未デバッグ）
2021-06-13 速度制御タスクをリファクタリング（ビルドエラーなし）
2021-06-16 リファクタリング完了！！！！
2021-06-17 角度制御のデモ動作完成
