F-Sakashita/Micromouse/(notices)

Notices in the files:
firmware/Test_ICM-20602/Core/Inc/main.h:
© Copyright (c) 2020 STMicroelectronics.
All rights reserved.
This software component is licensed by ST under BSD 3-Clause license,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
